Jeija/esp8266-povslinger/firmware/legacy/README.md

`ledbar.c` and `ledbar.h` is a bit-banging driver for the APA102-2020 LEDs on the POV-slinger board which has now been replaced by the hardware SPI driver in `src`.
