Jeija/esp8266-povslinger/stencilholder/holder.stl

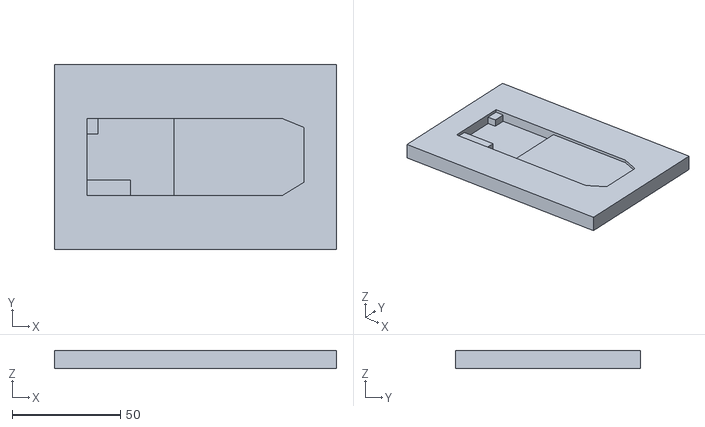
[picture p1: CAD file, 2017-12-31]
stencilholder/holder.stl
130.1 x 85.3 x 8.50
