Jeija/esp8266-povslinger/hardware/prototype/povslinger.kicad_pcb

## KiCad design hardware/prototype/povslinger.kicad_pcb (2017-12-31)

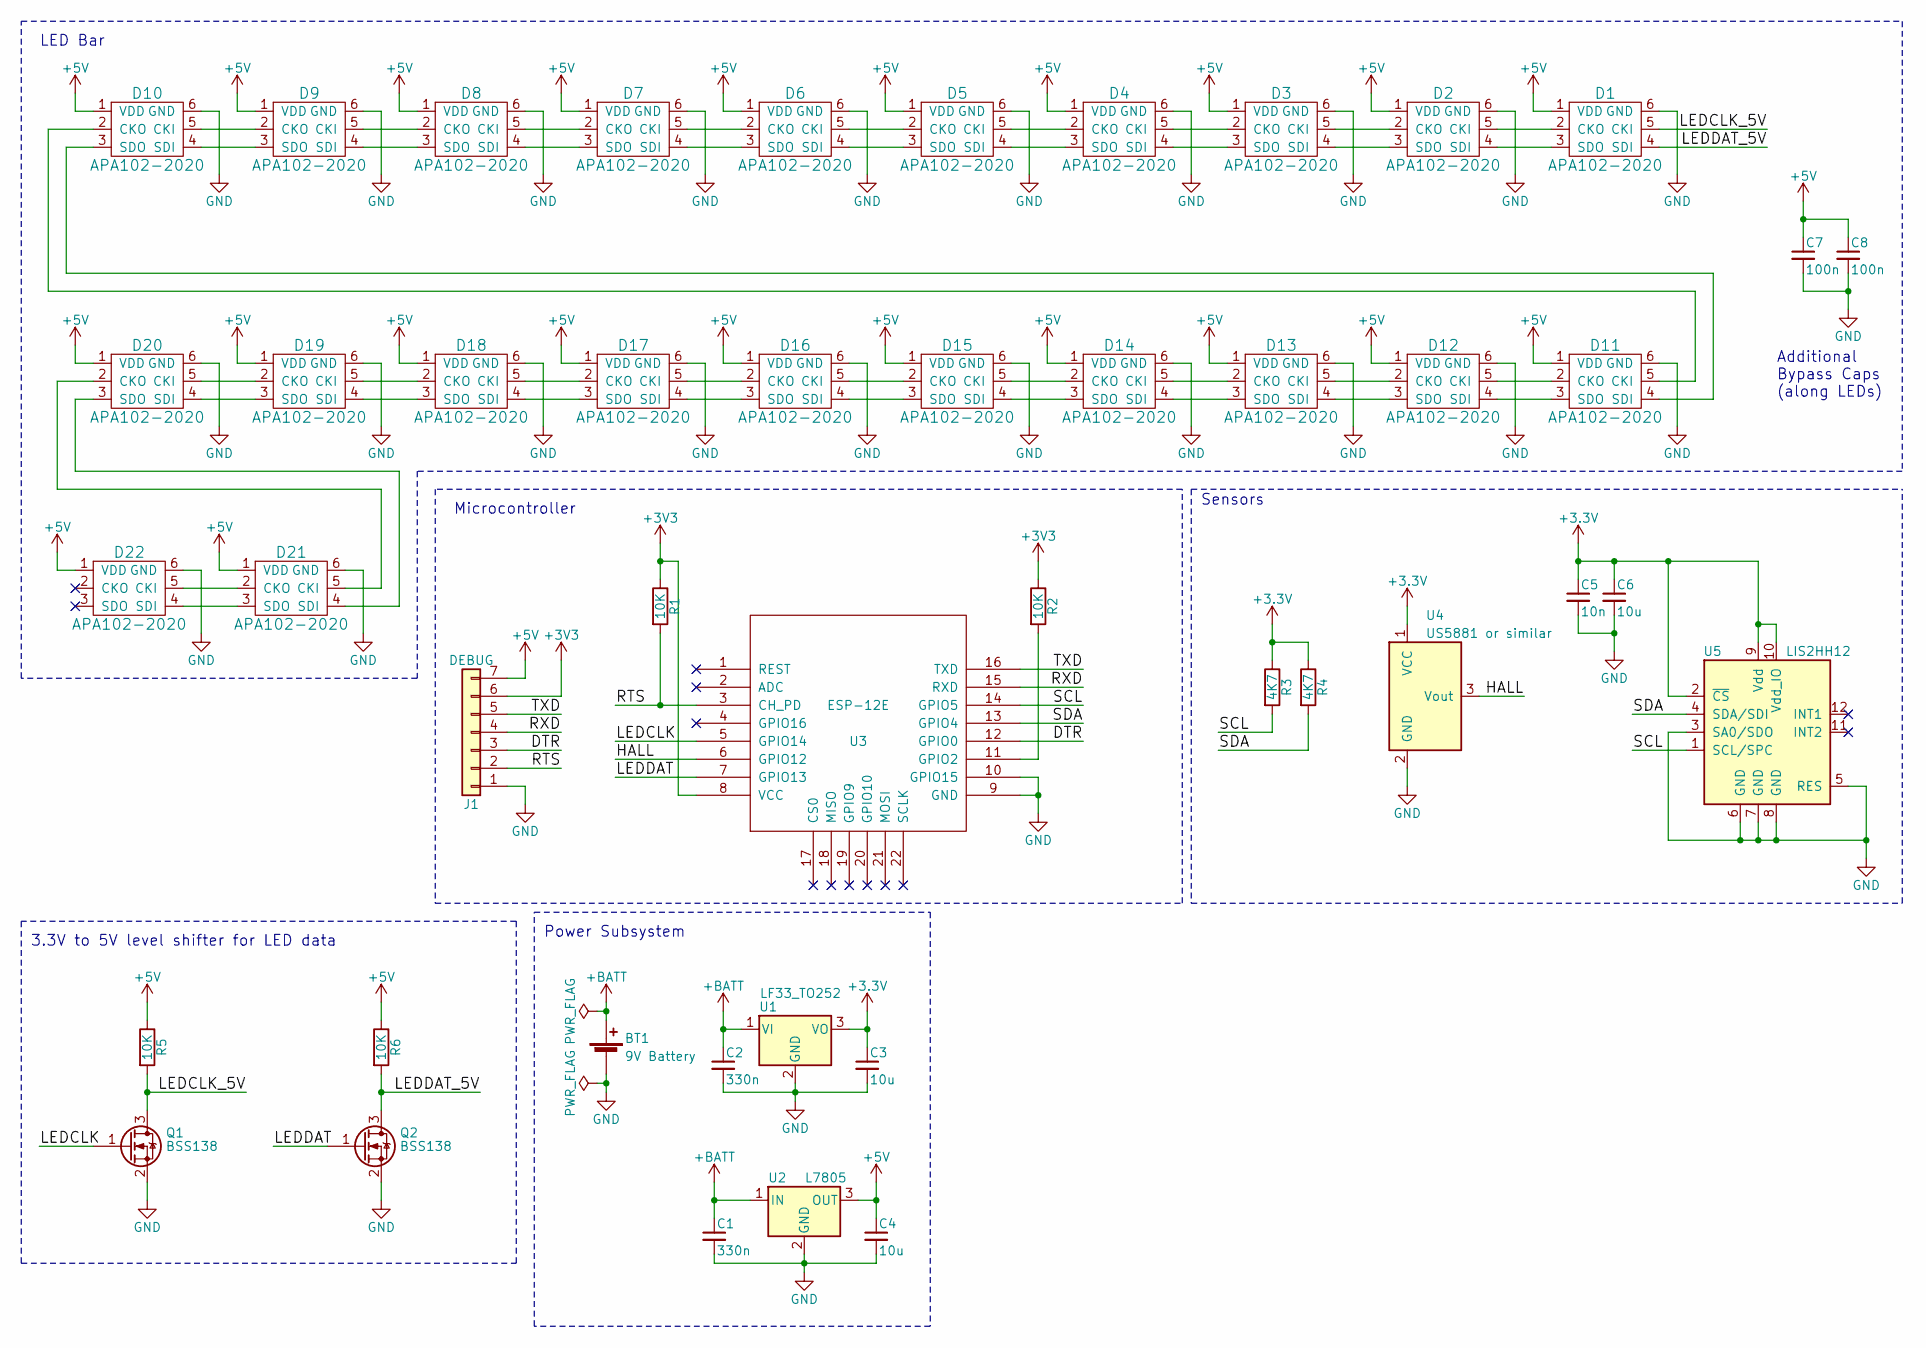
[picture p2: schematic povslinger.sch]

Parts:
BT1: 9V Battery; BatteryHolder_9Volt_Keystone_1294
C1, C2: 330n; C_0603
C3, C4, C6: 10u; C_0603
C5: 10n; C_0603
C7, C8: 100n; C_0603
D1, D2, D3, D4, D5, D6, D7, D8, D9, D10, D11, D12, D13, D14, D15, D16, D17, D18, D19, D20, D21, D22: APA102-2020
J1: DEBUG; Pin_Header_Straight_1x07_Pitch2.54mm
Q1, Q2: BSS138; SOT-23
R1, R2, R5, R6: 10K; R_0603
R3, R4: 4K7; R_0603
U1: LF33_TO252; TO-252-2
U2: L7805; TO-252-2
U3: ESP-12E; ESP-12E_SMD
U4: US5881 or similar; TO-92_Inline_Wide
U5: LIS2HH12; LIS2DH12

Connections:
+5V: C4.1, C7.1, C8.1, D1.1 (VDD), D2.1 (VDD), D3.1 (VDD), D4.1 (VDD), D5.1 (VDD), D6.1 (VDD), D7.1 (VDD), D8.1 (VDD), D9.1 (VDD), D10.1 (VDD), D11.1 (VDD), D12.1 (VDD), D13.1 (VDD), D14.1 (VDD), D15.1 (VDD), D16.1 (VDD), D17.1 (VDD), D18.1 (VDD), D19.1 (VDD), D20.1 (VDD), D21.1 (VDD), D22.1 (VDD), J1.7, R5.1, R6.1, U2.3 (OUT)
+BATT: BT1.1 (+), C1.1, C2.1, U1.1 (VI), U2.1 (IN)
/DTR: J1.3, U3.12 (GPIO0)
/HALL: U3.6 (GPIO12), U4.3 (Vout)
/LEDCLK: Q1.1 (G), U3.5 (GPIO14)
/LEDCLK_5V: D1.5 (CKI), Q1.3 (D), R5.2
/LEDDAT: Q2.1 (G), U3.7 (GPIO13)
/LEDDAT_5V: D1.4 (SDI), Q2.3 (D), R6.2
/RTS: J1.2, R1.2, U3.3 (CH_PD)
/RXD: J1.4, U3.15 (RXD)
/SCL: R3.2, U3.14 (GPIO5), U5.1 (SCL/SPC)
/SDA: R4.2, U3.13 (GPIO4), U5.4 (SDA/SDI)
/TXD: J1.5, U3.16 (TXD)
GND: BT1.2 (-), C1.2, C2.2, C3.2, C4.2, C5.2, C6.2, C7.2, C8.2, D1.6 (GND), D2.6 (GND), D3.6 (GND), D4.6 (GND), D5.6 (GND), D6.6 (GND), D7.6 (GND), D8.6 (GND), D9.6 (GND), D10.6 (GND), D11.6 (GND), D12.6 (GND), D13.6 (GND), D14.6 (GND), D15.6 (GND), D16.6 (GND), D17.6 (GND), D18.6 (GND), D19.6 (GND), D20.6 (GND), D21.6 (GND), D22.6 (GND), J1.1, Q1.2 (S), Q2.2 (S), U1.2 (GND), U2.2 (GND), U3.9 (GND), U3.10 (GPIO15), U4.2 (GND), U5.3 (SA0/SDO), U5.5 (RES), U5.6 (GND), U5.7 (GND), U5.8 (GND)
unnamed: D1.2 (CKO), D2.5 (CKI)
unnamed: D1.3 (SDO), D2.4 (SDI)
unnamed: D2.2 (CKO), D3.5 (CKI)
unnamed: D2.3 (SDO), D3.4 (SDI)
unnamed: D3.2 (CKO), D4.5 (CKI)
unnamed: D3.3 (SDO), D4.4 (SDI)
unnamed: D4.2 (CKO), D5.5 (CKI)
unnamed: D4.3 (SDO), D5.4 (SDI)
unnamed: D5.2 (CKO), D6.5 (CKI)
unnamed: D5.3 (SDO), D6.4 (SDI)
unnamed: D6.2 (CKO), D7.5 (CKI)
unnamed: D6.3 (SDO), D7.4 (SDI)
unnamed: D7.2 (CKO), D8.5 (CKI)
unnamed: D7.3 (SDO), D8.4 (SDI)
unnamed: D8.2 (CKO), D9.5 (CKI)
unnamed: D8.3 (SDO), D9.4 (SDI)
unnamed: D10.2 (CKO), D11.5 (CKI)
unnamed: D10.3 (SDO), D11.4 (SDI)
unnamed: D9.3 (SDO), D10.4 (SDI)
unnamed: D9.2 (CKO), D10.5 (CKI)
unnamed: D11.2 (CKO), D12.5 (CKI)
unnamed: D11.3 (SDO), D12.4 (SDI)
unnamed: D12.2 (CKO), D13.5 (CKI)
unnamed: D12.3 (SDO), D13.4 (SDI)
unnamed: D13.2 (CKO), D14.5 (CKI)
unnamed: D13.3 (SDO), D14.4 (SDI)
unnamed: D14.2 (CKO), D15.5 (CKI)
unnamed: D14.3 (SDO), D15.4 (SDI)
unnamed: D15.2 (CKO), D16.5 (CKI)
unnamed: D15.3 (SDO), D16.4 (SDI)
unnamed: D16.2 (CKO), D17.5 (CKI)
unnamed: D16.3 (SDO), D17.4 (SDI)
unnamed: D17.2 (CKO), D18.5 (CKI)
unnamed: D17.3 (SDO), D18.4 (SDI)
unnamed: D18.2 (CKO), D19.5 (CKI)
unnamed: D18.3 (SDO), D19.4 (SDI)
unnamed: D19.2 (CKO), D20.5 (CKI)
unnamed: D19.3 (SDO), D20.4 (SDI)
unnamed: D20.2 (CKO), D21.5 (CKI)
unnamed: D20.3 (SDO), D21.4 (SDI)
unnamed: D21.2 (CKO), D22.5 (CKI)
unnamed: D21.3 (SDO), D22.4 (SDI)
unnamed: R2.2, U3.11 (GPIO2)

Notes on the sheet:
Additional Bypass Caps (along LEDs)
Power Subsystem
Sensors
Microcontroller
LED Bar
3.3V to 5V level shifter for LED data

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
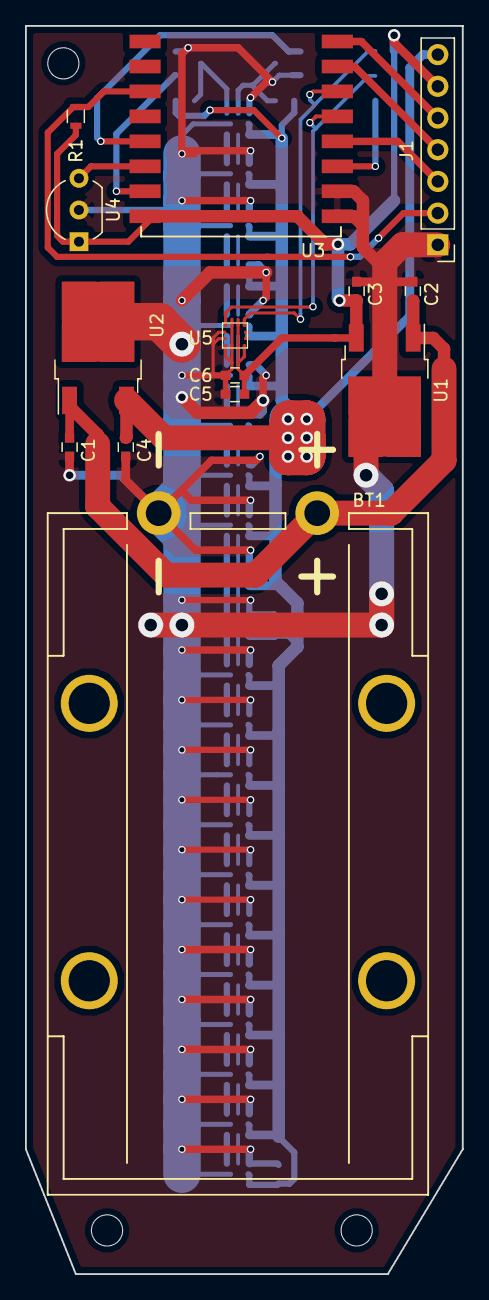
[picture p3: board povslinger.kicad_pcb from above]

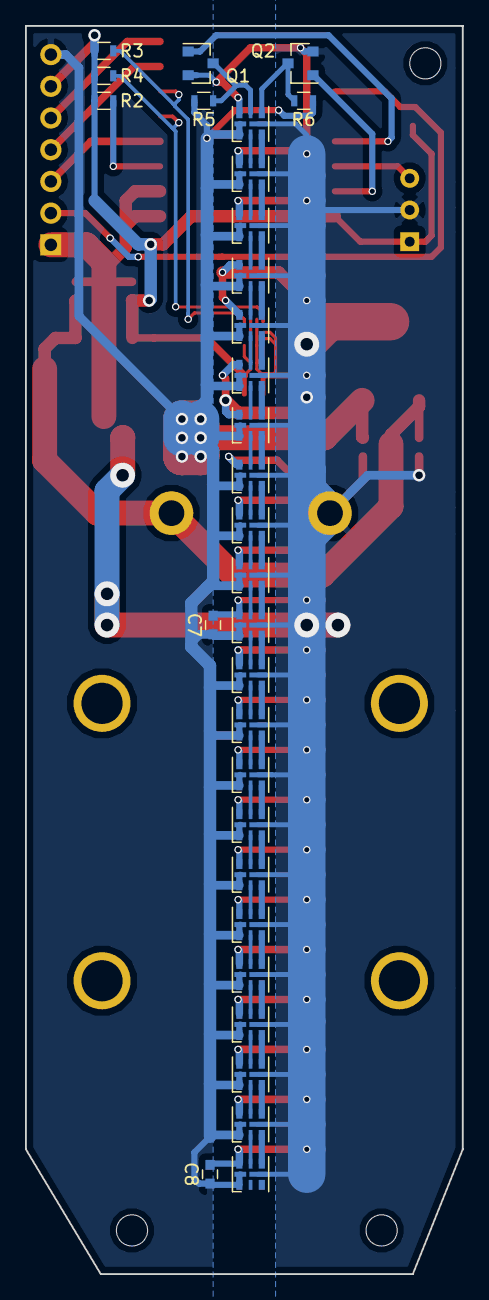
[picture p4: board povslinger.kicad_pcb from below]

Board: 2 copper layers, 35.0 x 100.0 mm, 45 parts (31 on the bottom side), 58 nets.
