Jeija/esp8266-povslinger/firmware/src/function_pixelart_data.h

#include <os_type.h>

#define PIXELART_IMGCOUNT 6

static const uint32_t pixelart_indices[] = {
	// format: offset, width, height
	// filename: europe.png, size: 25 x 22
	0, 25, 22,
	// filename: nyancat.png, size: 31 x 19
	1650, 31, 19,
	// filename: spaceinvaders.png, size: 12 x 12
	3417, 12, 12,
	// filename: radioactive.png, size: 22 x 22
	3849, 22, 22,
	// filename: 1up.png, size: 16 x 16
	5301, 16, 16,
	// filename: rainbow.png, size: 22 x 22
	6069, 22, 22
};

static const uint8_t pixelart_data[] ICACHE_RODATA_ATTR = {
	0x00, 0x1f, 0x7e, 0x00, 0x1f, 0x7e, 0x00, 0x1f, 0x7e, 0x00, 0x1f, 0x7e, 0x00, 0x1f, 0x7e, 0x00, 0x1f, 0x7e, 0x00, 0x1f, 0x7e, 0x00, 0x1f, 0x7e, 0x00, 0x1f, 0x7e, 0x00, 0x1f, 0x7e, 0x00, 0x1f, 0x7e, 0x00, 0x1f, 0x7e, 0x00, 0x1f, 0x7e, 0x00, 0x1f, 0x7e, 0x00, 0x1f, 0x7e, 0x00, 0x1f, 0x7e, 0x00, 0x1f, 0x7e, 0x00, 0x1f, 0x7e, 0x00, 0x1f, 0x7e, 0x00, 0x1f, 0x7e, 0x00, 0x1f, 0x7e, 0x00, 0x1f, 0x7e, 0x00, 0x1f, 0x7e, 0x00, 0x1f, 0x7e, 0x00, 0x1f, 0x7e,
	0x00, 0x1f, 0x7e, 0x00, 0x1f, 0x7e, 0x00, 0x1f, 0x7e, 0x00, 0x1f, 0x7e, 0x00, 0x1f, 0x7e, 0x00, 0x1f, 0x7e, 0x00, 0x1f, 0x7e, 0x00, 0x1f, 0x7e, 0x00, 0x1f, 0x7e, 0x00, 0x1f, 0x7e, 0x00, 0x1f, 0x7e, 0x00, 0x1f, 0x7e, 0x00, 0x1d, 0x83, 0x00, 0x1f, 0x7e, 0x00, 0x1f, 0x7e, 0x00, 0x1f, 0x7e, 0x00, 0x1f, 0x7e, 0x00, 0x1f, 0x7e, 0x00, 0x1f, 0x7e, 0x00, 0x1f, 0x7e, 0x00, 0x1f, 0x7e, 0x00, 0x1f, 0x7e, 0x00, 0x1f, 0x7e, 0x00, 0x1f, 0x7e, 0x00, 0x1f, 0x7e,
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
	0x07, 0x00, 0x00, 0x2b, 0x00, 0x00, 0x27, 0x02, 0x00, 0x31, 0x29, 0x00, 0x1e, 0x21, 0x00, 0x10, 0x20, 0x00, 0x00, 0x14, 0x0a, 0x00, 0x0d, 0x1e, 0x09, 0x00, 0x16, 0x1c, 0x00, 0x17, 0x09, 0x00, 0x07, 0x00, 0x00, 0x00, 0x00, 0x00, 0x00, 0x00, 0x00, 0x00, 0x00, 0x00, 0x00, 0x00, 0x00, 0x00, 0x00, 0x00, 0x00, 0x00, 0x00, 0x00, 0x00, 0x00, 0x00, 0x00, 0x00, 0x00, 0x00, 0x00, 0x00, 0x00, 0x00, 0x00
};
