Jeija/esp8266-povslinger/firmware/src/function_placehearts.h

/*
 * Main menu function - Display hearts pattern
 */
#include <os_type.h>

#include "ledbar_spi.h"

#ifndef _FUNCTION_PLACEHEARTS_H
#define _FUNCTION_PLACEHEARTS_H

void function_placehearts(int32_t xpos, uint8_t ypos, uint32_t millis, Color *rgb);

#endif
