Jeija/esp8266-povslinger/firmware/src/function_text.h

/*
 * Main menu function - Display text
 */
#include <os_type.h>

#include "ledbar_spi.h"

#ifndef _FUNCTION_TEXT_H
#define _FUNCTION_TEXT_H

void function_text(int32_t xpos, uint8_t ypos, uint32_t millis, Color *rgb);

#endif
