Jeija/esp8266-povslinger/(commit log)

2017-12-31 Initial version control checkin, including:
    * Prototype and production hardware schematic and PCB designs
    * Firmware prototype
    * Debugging output server written in python
    * 3D model for PCB and solder paste stencil holder, can e.g. be 3D printed
    * Resources for mathematical models used in firmware (low pass filter + acceleration model)
    [holder.scad, holder.stl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]
2018-01-14 Update some resistor values, remove backup schematics
    [povslinger.sch]
2018-01-17 Firmware: Add temperature function
2018-01-17 Firmware: Add pixel art function
    Production Schematic: Minor layout improvements
    [povslinger.sch]
2018-01-18 Schematic: Add description, repo link
    [povslinger.sch]
